studiociodo/Gestione-Allarmi-Arduino/README.md

# Gestione-Allarmi-Arduino
 Designed PCB and Software to make a DIN Mount Dry-Contact Alarm with Arduino or Raspberry
 See result on Youtube (https://www.youtube.com/watch?v=09R2AqicpwQ)
