studiociodo/Gestione-Allarmi-Arduino/schematic/collegamenti dei moduli.png

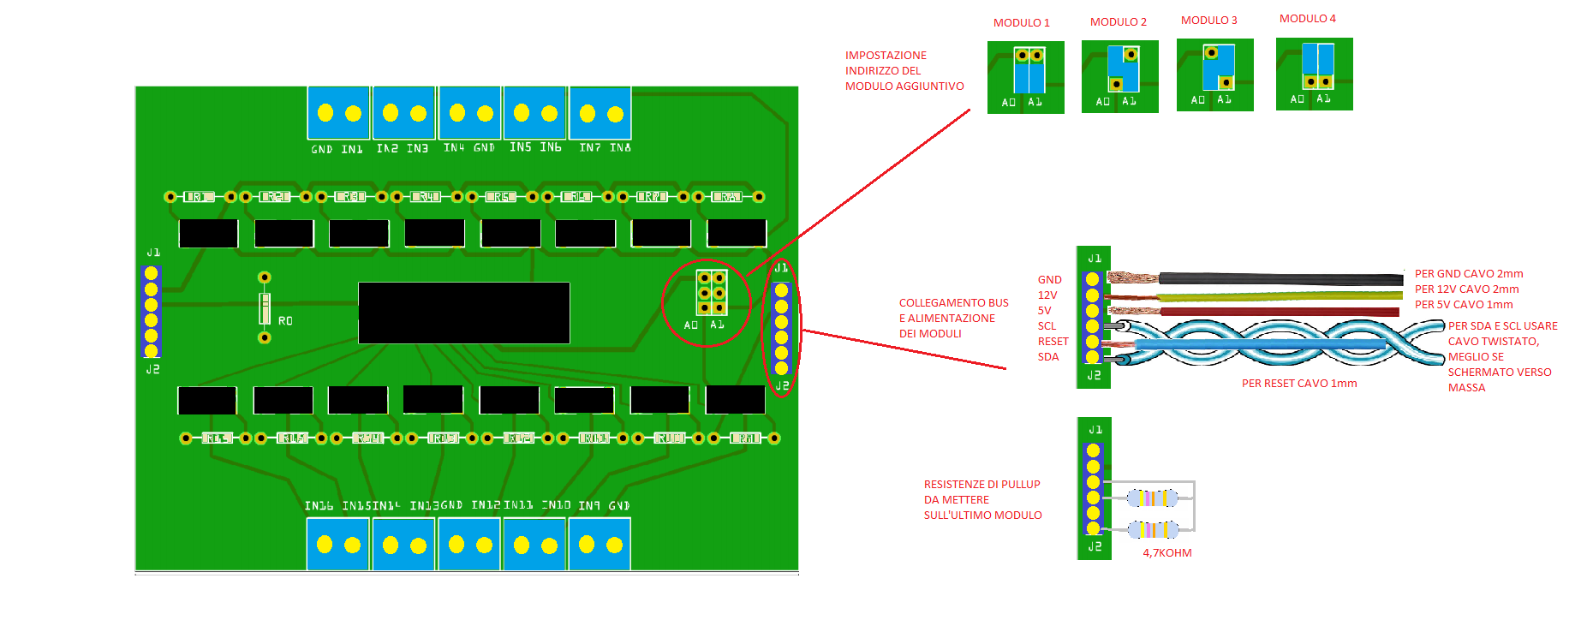
schematic/collegamenti dei moduli.png
