studiociodo/Gestione-Allarmi-Arduino/schematic/modulo ingressi/moduloIN_bb.pdf

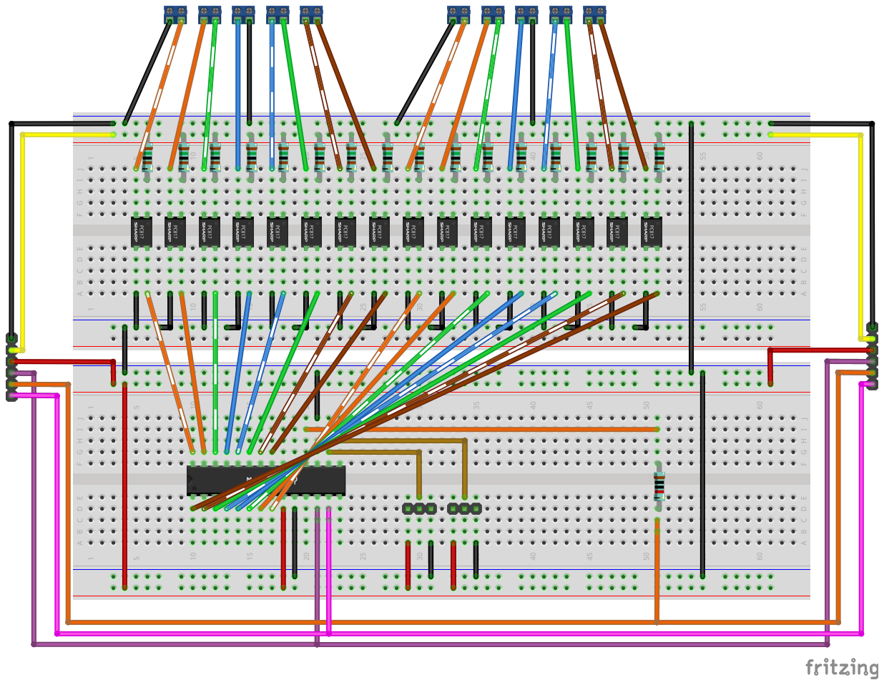
[picture p2: page 1]
