studiociodo/Gestione-Allarmi-Arduino/schematic/modulo mcu/modulo mcu_bb.pdf

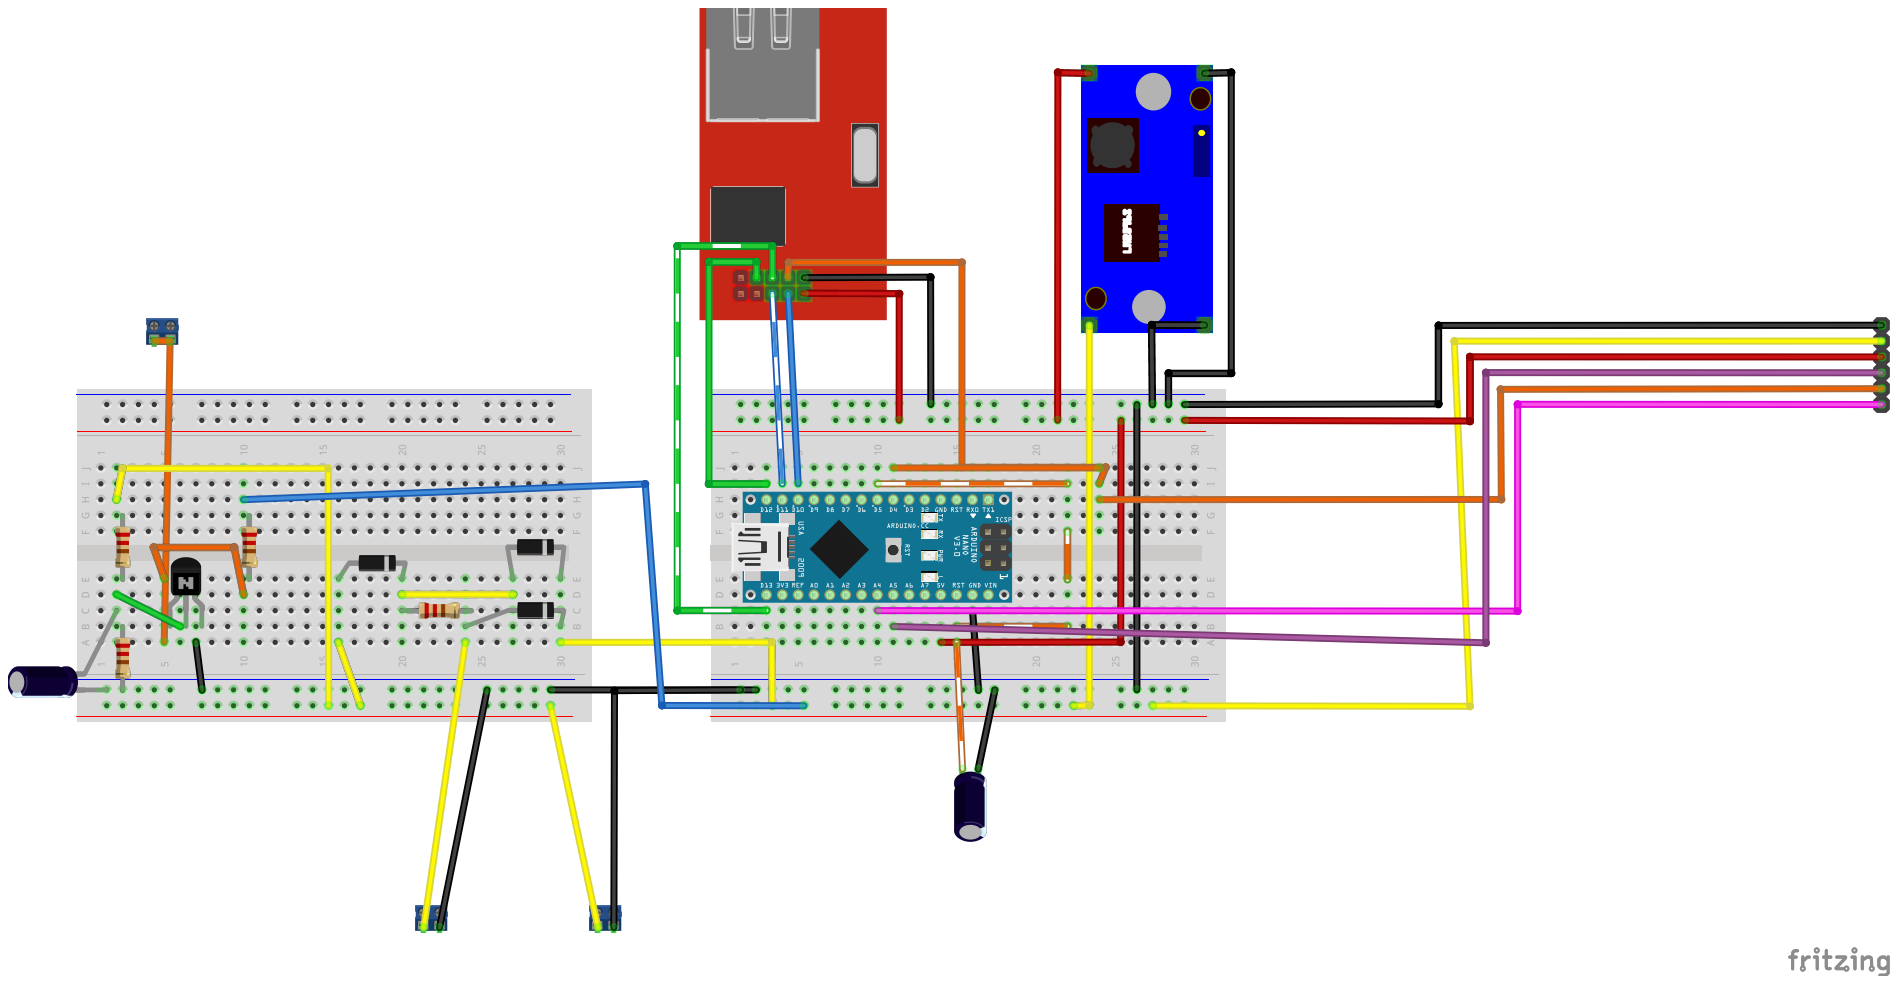
[picture p3: page 1]
