studiociodo/Gestione-Allarmi-Arduino/schematic/modulo mcu/modulo mcu_pcb.pdf

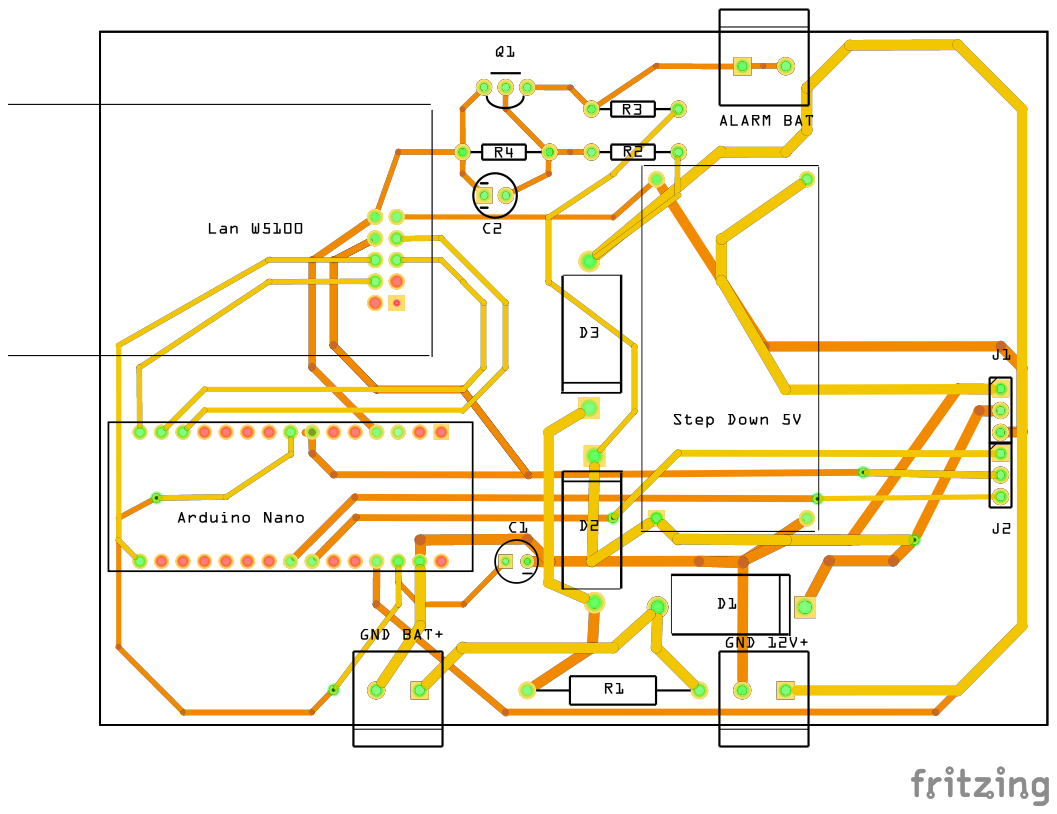
[picture p4: page 1]
