studiociodo/Gestione-Allarmi-Arduino/schematic/modulo mcu/modulo_mcu_v2_pcb.pdf

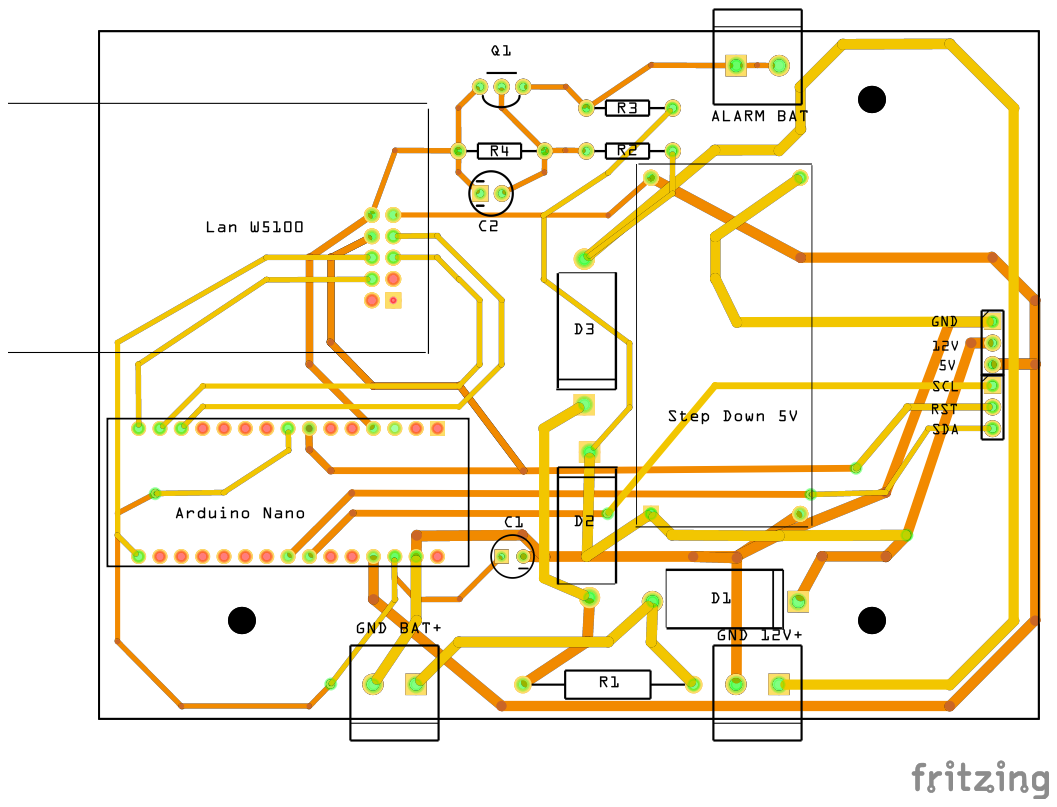
[picture p5: page 1]
