studiociodo/Gestione-Allarmi-Arduino/schematic/raspberry mcu/raspberry mcu_bb.pdf

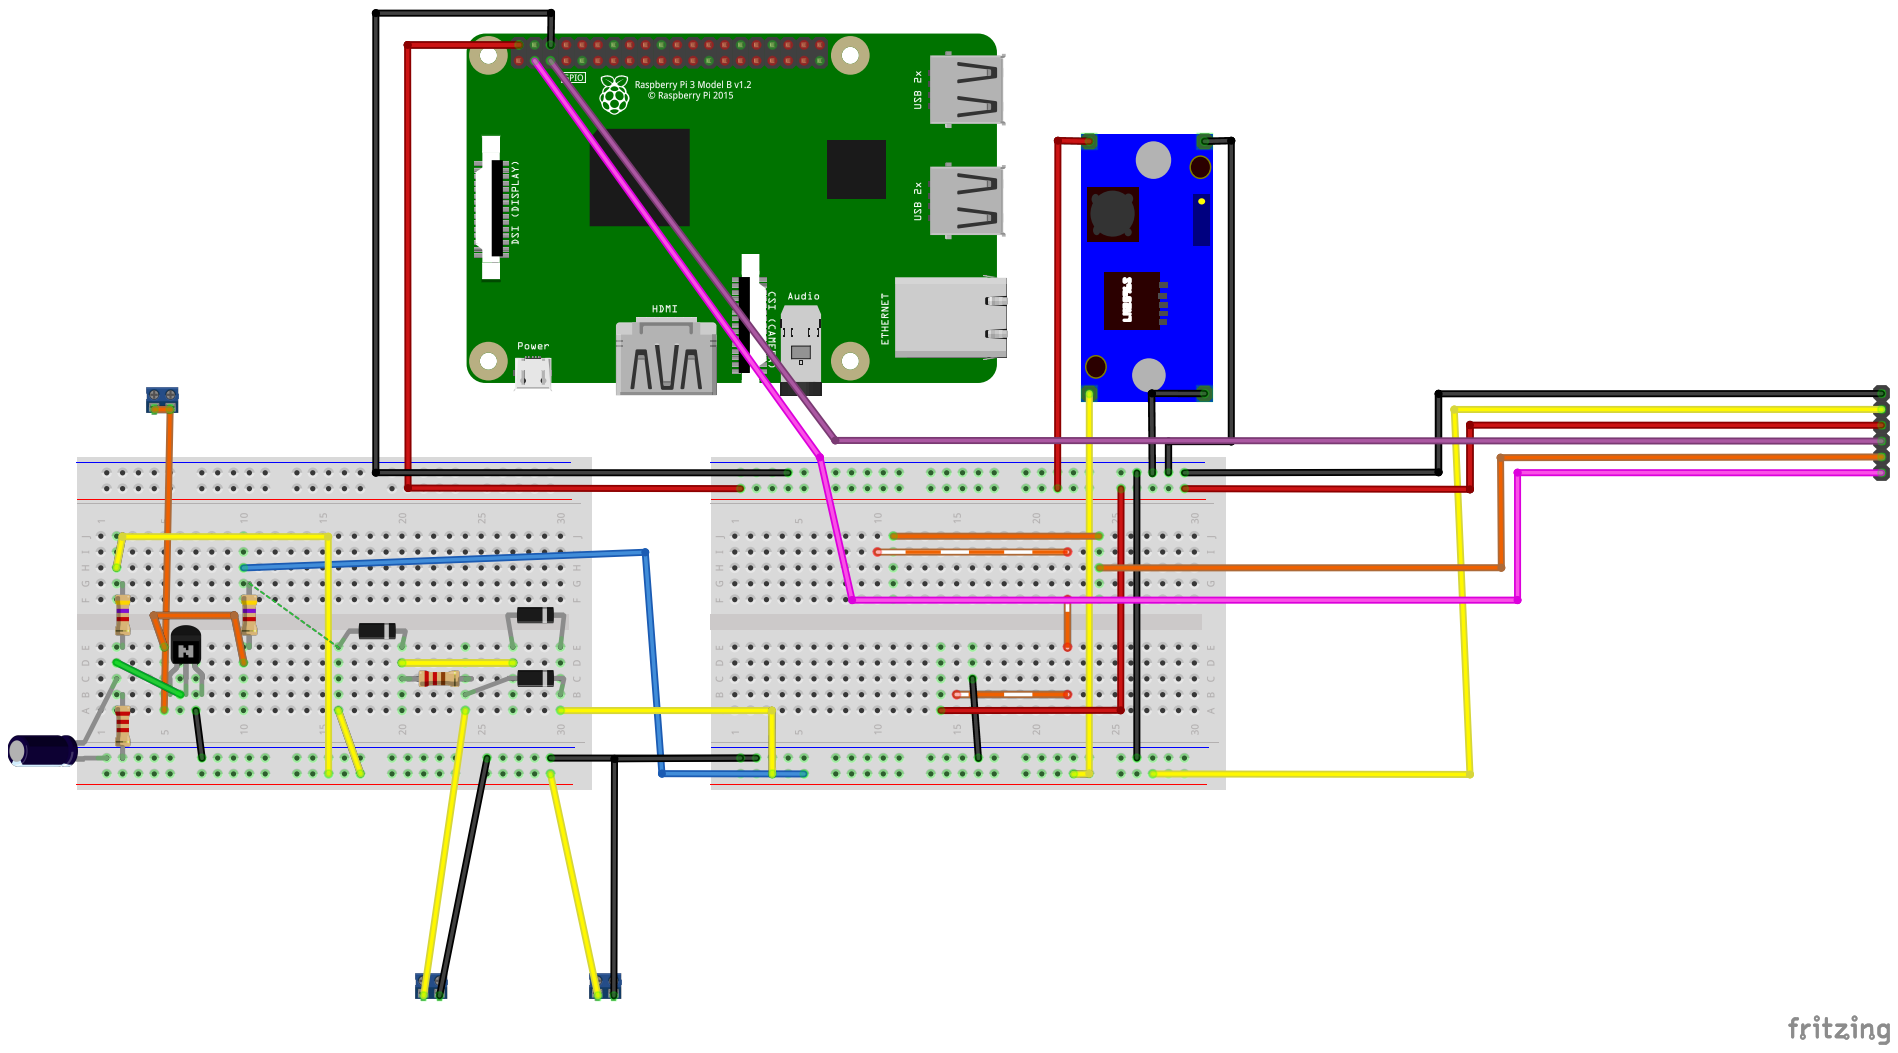
[picture p6: page 1]
