studiociodo/Gestione-Allarmi-Arduino/schematic/raspberry mcu/raspberry mcu_pcb.pdf

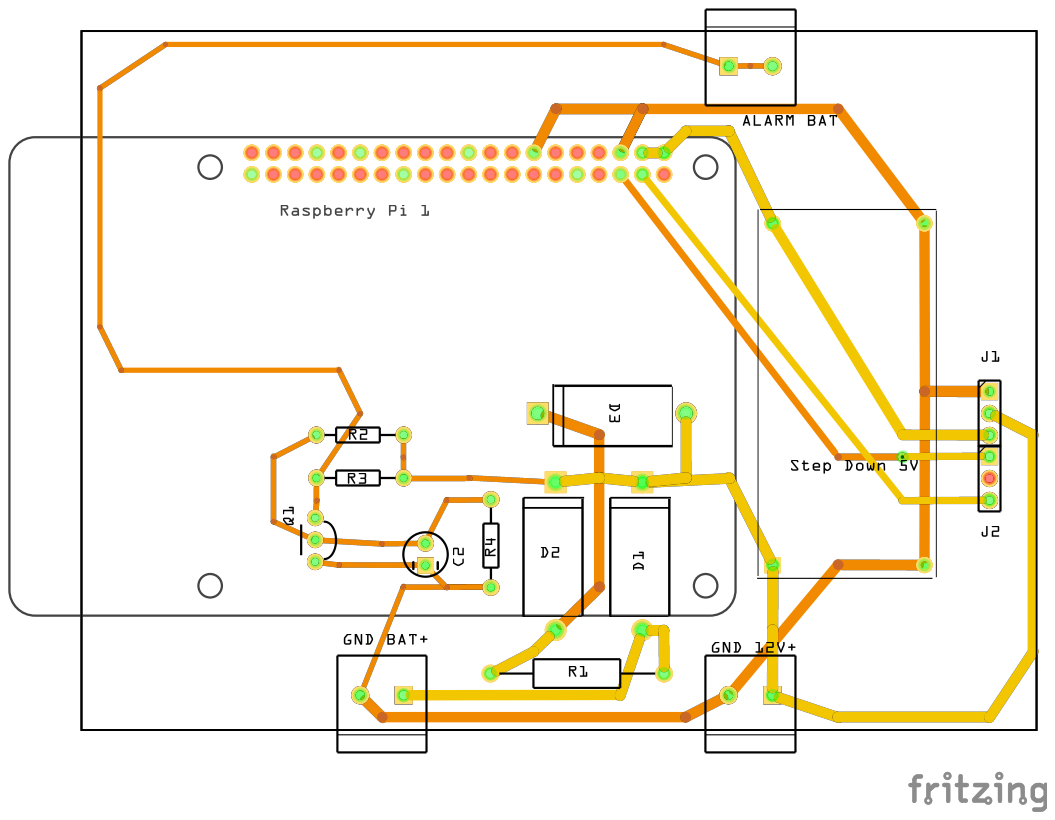
[picture p7: page 1]
