studiociodo/Gestione-Allarmi-Arduino/(list of files, drawings)

Other design files:
schematic/modulo ingressi/moduloIN.fzz
schematic/modulo ingressi/moduloIN_v2.fzz
schematic/modulo mcu/modulo mcu.fzz
schematic/modulo mcu/modulo_mcu_v2.fzz
schematic/raspberry mcu/raspberry mcu.fzz
